lrswss/esp8266-wifi-power-meter/(threads)

Thread 1 (2021-04-17):

Code Beschreibung

Sjirka83, 2021-04-17:
Hallo Lars,

tolles Projekt, dass endlich mal die analoge Schnittstelle des Sensors nutzt und da drauf die Impulse des Stromzählers ausließt.
Mit der digitalen Ausgabe hatte ich genau die gleichen Probleme, dass der Schwellwert einfach nicht zu finden war.
Deine Lösung ist wohl der perfekte Weg, wenn man den alten Zähler gerne auslesen möchte. Super Umsetzung!!!

Da ich aber absolut neu in Sachen Arduino und der Microcontrollertechnik bin, habe ich etwas Schwierigkeiten den Code für meine Bedürfnisse anzupassen bzw. alle Abschnitte korrekt zu verstehen.

1. Ich kann den Gesamtverbrauch mit http://<ip>/setCounter?set=18231.1 nicht anpassen. Dieser schlägt immer fehl. Muss ich hier noch etwas anderes beachten?
2. Kann ich per http Befehl den Schwellwert anpassen, so dass ich diesen noch etwas "nachjustieren" kann?
3. Wie oft wird der EEPROM mit dem aktuellen Wert aktualisiert? Wenn ich das System neustarte, wird der EEPROM beschrieben, doch passiert es auch automatisch zwischendurch?!
4. Kannst du den Code auch ohne Anbindung von MQTT etc. bereitstellen? Die Ausgabe aller Werte einfach nur als JSON erweitern, so dass diese per http abgefragt werden können? Ich habe zwar die Ausgabe bereits realisiert, doch im "Code" einfach nach meinem "Wissen" hinzugefügt. Das geht bestimmt noch besser. :-)

Auch wenn das Projekt schon etwas her ist, würde ich mich sehr freuen, wenn du mir eine Rückmeldung zu den Fragen geben kannst.

Viele Grüße

lrswss, 2021-04-20:
Ich muss leider zugeben, dass ich schon eine ganze Weile eine neuere Version bei mir (als Sensor für Home Assistant) in Betrieb habe, es aber bisher irgendwie versäumt hatte, diese auch hier mal (dokumentiert) hochzuladen. :blush: Deine Anregungen ließen sich alle recht leicht umsetzen. Es ist also endlich Zeit für eine v1.2!

zu 1) Die Doku zu diesem Befehl im Code war fehlerhaft, hab's nun ins README aufgenommen.
zu 2) Ich habe einen passenden Befehl (setThreshold) implementiert (siehe README).
zu 3) Counter, CounterOffset und ImpulseThreshold werden alle 60 Min. gespeichert (früher 120 Min.).
zu 4) Ist nun beides auch möglich: ENABLE_MQTT auskommentieren bzw. /readings für den RESTful Aufruf nutzen.

Bitte testen. Über ein Feedback würde ich mich freuen...

Grüße
Lars

Sjirka83, 2021-04-20:
Hallo,

vielen vielen Dank für die ausführlichen Infos. Ich werde testen und berichten. :-)
Ich habe den Zähler jetzt ein paar Tage bereits laufen lassen. Der Zähler läuft einwandfrei und nach ein wenig justieren, wirklich sehr genau.... BIS der Durchlauferhitzer anspringt. Dann liegen 21 KW Drehstrom an und die Scheibe rennt! Leider mit den jetzigen Einstellungen zu schnell um die rote Makierung noch zu erkennen. Wenn ich den Code richtig verstehe, muss der Pegel für die Erkennung des silbernen Bereiches erst eine gewisse Zeit gehalten werden, bis der rote Bereich "neu" gezählt werden darf?!? Oder würde es schon reichen die "Debouncezeit" niedriger zu stellen. Wie könnte das denn erfolgen?!

Im ESPEASY habe ich den Sensor einmal als "Switch" konfiguriert um zu schauen, ob ich die sehr schnellen Impulse zählen könnte. So wird nur der Zustand 1 und 0 im Wechsel gezählt, was dazu führt das der Zähler sehr genau, unabhängig der Zeit für eine Runde und sehr schnell reagiert. Problem ist hier nur wieder die Einstellung des Sensors dann direkt an der Scheibe selbst. Aufgrund des Digitalen Ausgangs, kann nur der Potentiometer zur Einstellungen genommen werden, doch dieser gleicht eher dem Glaskugellesen.

Gerne würde ich an der anlogen Variante noch ein wenig "rumfeilen", da sie an sich wunderbar läuft und für alle weiteren Auswertungen sehr komfortabel ist. Würde aus deiner Erfahrung die Einstellung der Debouncetime hier noch etwas bringen um eine ganz langsam drehende Scheibe, so wie die sehr schnelle Bewegung zählen zu können?

Viele Grüße

lrswss, 2021-04-21:
So schnell dreht sich bei uns die Schreibe glücklicherweise nie. :astonished: Den Code hatte ich mal kurz mit etwa 10kW (Ofen, Toaster, Fön, Wasserkocher,...) getestet. Ich nehme mal an, deine TURNS_PER_KWH liegen auch bei 75, oder? In deinem Fall würde ich tatsächlich IMPULSE_DEBOUNCE_SEC auf 2 Sekunden reduzieren (sollte dann bei ca. 27 Umdrehungen pro Min. knapp passen) und auch die Abtastrate READINGS_INTERVAL_MS von 100 auf 50 ms anpassen. Ansonsten vllt. auch mal die Debug-Möglichkeit mit InfluxDB/Grafana ausprobieren; dann sieht's du die abgetasteten Impulse besser und kannst die Parameter entsprechend gezielter anpassen.

lrswss, 2021-05-08:
Und, hat die Anpassung von IMPULSE_DEBOUNCE_SEC bzw. READINGS_INTERVAL_MS den gewünschten Erfolg gebracht?

Closed 2021-07-24.

Thread 2 (2021-08-08):

error: call of overloaded 'abs(uint32_t)' is ambiguous

Conor-Burns, 2021-08-08:
Hi,
sehr cooles Projekt da es den Analogen output benutzt!
Leider erhalte ich beim kompilieren den Fehler im Titel für die Zeilen: 331, 793, 838 und 857

lrswss, 2021-08-09:
Da ich inzwischen (für andere Projekte) auf PlatformIO umgestiegen bin, hatte ich meine Arduino IDE schon eine Weile nicht mehr aktualisiert. Mit der 1.8.10 gibt es (noch) keine Warnungen, mit der aktuellen 1.8.15 und aktuellen ESP8266 Tools hingegen schon. Ich habe den problematisch `abs(uint32_t)` Aufruf für den Zeitstempelvergleich mit millis() nun in ein eigene Funktion verpackt.

Conor-Burns, 2021-08-09:
Ja ich benutze auch platformio für alles und hatte das importiert.

Dankeschön ich probier das nachher mal aus

Conor-Burns, 2021-08-10:
@lrswss Das funktioniert soweit doch jetzt hab ich dieses problem:
```
  431 |     snprintf(clientid, sizeof(clientid), MQTT_CLIENT_ID, random(0xffff));
      |                                          ^~~~~~~~~~~~~~
Compiling .pio/build/d1_mini/FrameworkArduino/StreamSend.cpp.o
Compiling .pio/build/d1_mini/FrameworkArduino/Tone.cpp.o
Compiling .pio/build/d1_mini/FrameworkArduino/TypeConversion.cpp.o
/home/conor/Documents/PlatformIO/Projects/210808-200442-d1_mini/src/esp8266-wifi-power-meter.ino:469:1: error: control reaches end of non-void function [-Werror=return-type]
  469 | }
      | ^
```

lrswss, 2021-08-12:
So, das Projekt lässt sich nun auch unter PlatformIO compilieren.

Conor-Burns, 2021-08-20:
mega, dankeschön!

Closed 2021-08-20.

Thread 3 (2022-07-13):

MQTT Broker connection failed

xxLexanixx, 2022-07-13:
[12:43:11]Connecting to MQTT Broker 192.168.xxx.xxx as PowerMeter_1e9cc...failed (error 5)
[12:43:12]Connecting to MQTT Broker 192.168.xxx.xxx as PowerMeter_ba257...failed (error 5)
[12:43:13]Connecting to MQTT Broker 192.168.xxx.xxx as PowerMeter_91488...failed (error 5)

lrswss, 2022-07-13:
Believe it or not, the code for an authenticated mqtt connection was simply missing. :blush: Fixed with 2.1.2.

Closed 2022-07-13.

Thread 4 (2022-07-16):

Meter number

nonick321, 2022-07-16:
Hi,

thanks for your hard work, it works like a charm :-).

I'm wondering where in the code i can change the meter-number. Here it is sth like 078893. i'd like to change it to the real meter-number from the Stromnetzbetreiber :-), especially because the number shows up in the mqtt-message.

Feature request: Mqtt Port in the GUI.

btw: You didn't change the Version number to 212 in config.h .. Don't know if that matters..

btw2: Is there a reason why WiFiUDP.h isn't in your Code? Perhaps you should mention it in your readme.

Cheers,
Alex

lrswss, 2022-07-17:
The number is derived from the MAC address of the ESP8266, but making it configurable is no big deal. Same holds true for the MQTT port.

The header file WiFiUDP.h is included in influx.h. Do you get compiler warnings/errors or why are you asking? Mentioning the old version number I guess you're using the Arduino IDE, right? I switched to VisualStudio/PlatformIO quite a while ago, so I no longer compile the code explicitly under the Arduino IDE.

nonick321, 2022-07-17:
Thank you, I found the codeparts with the MAC or systemID Call.

No, i freshly installed Visual Code and PlatformIO. I then cloned into your repository and opened the folder in Visual Code. The compiler complained about the missing WiFiUDP.h.  After adding it manually under "include", the compilation went through without errors.

sorry, i'm new to this whole stuff. This is my first project ...

Another Question: I added your Project via MQTT to iobroker. MQTT connection drops twice per minute with "connection lost: Timeout". Any idea how i can fix this? My fritzbox shows Signalstrength of -79 to -74 which is not too good, but the GUI is responsive

lrswss, 2022-07-17:
Just uploaded v2.1.3 with options in web ui to configure the MQTT port and power meter id. Please check if it's working as expected.

Sorry, I cannot reproduce your error due to missing header WiFiUDP.h. I cleaned up my project in VS and download/compiled all libraries from scratch: no warnings or errors message from the compiler.

I'm using HA and never experienced any connection timeout warnings. Low signal strength is probably not the cause. But I think the warnings are no matter of concern. Looking at the source code of the PubSubClient library I found MQTT_KEEPALIVE and MQTT_SOCKET_TIMEOUT to be set to 15 seconds by default. Timeout and keep alive could be increased with setSocketTimeout() and setKeepAlice() in mqtt.cpp which might fix iobroker's complains. You could try to set the publish interval to 30 or even 15 secs and check if you still get connect lost warnings.

nonick321, 2022-07-18:
Thank you so much. I changed the timeout and keepalive to 40 seconds and the publish intervall to 30s. The connection is now stable and no more warnings in iobrokers log.

All your other changes (Meter Name, Port) work great. Thanks for this!

Closed 2022-07-18.

Thread 7 (2022-10-16):

Revolutions not counted when using > 500 Watts

jellekaufmann, 2022-10-16:
Hi Lars,

I finally managed to get the power meter working correctly!

The final issue I ran into was revolutions not being counted when using a high amount of electricity.

Because calibration was working fine I figured the problem had to be in the rising edge detection.

Commenting out the two lines on row 105-106 of src/ferraris.cpp and using a 15ms sample rate fixed my problem.

I guess this is caused by my very fast spinning meter.

```
// try to find a rising edge in previous analog readings
static bool findRisingEdge() {
    uint16_t i, belowThresholdTrigger;
    uint8_t s = 1;
    uint16_t belowTh = 0;
    uint16_t aboveTh = 0;

    // reading interval min. 50ms
    //if (50 / settings.readingsIntervalMs > 1)
    //    s = 50 / settings.readingsIntervalMs;

    // min. number of pulses below threshold required to detect a rising edge
    belowThresholdTrigger = (settings.pulseDebounceMs / 2) / settings.readingsIntervalMs;

    i = ferraris.index > 0 ? ferraris.index : ferraris.size - 1;
```

I don't know how (or if) you want to resolve this issue, maybe a button on the advanced settings panel? Or turning off the minimum interval of 50ms when a fast spinning meter is configured?

Just let me know and I'll try to come up with a pull request.

Jelle

Closed 2022-11-13.

Thread 8 (2022-10-31):

Publish totalConsumption and runtime?

steakneedy, 2022-10-31:
Hi there,

first of all thanks for the great work!

Would it be possible to also publish the total consumption via MQTT or am missing something?
I can get the data by HTTP Request, but it would be great to also have this data directly available as an entity in Home Assistant.

Thanks

lrswss, 2022-11-01:
All 4 entities displayed in the web ui are published via MQTT along with RSSI and version number. Could you please check the messages published to your broker with MQTT Explorer oder mosquitto_sub on the topic you configured under "settings". Are you using the Arduino IDE or PlatformIO to compile the software? ArduinoJson Version? Operating system?

lrswss, 2022-11-01:
Could you please check the topic HA discovery topic homeassistant/sensor/wifipowermeter-74DAE9 with MQTT Explorer. You should see 5 entities: pulse_count, total_consumption, current_power, signal_strength and runtime. It might help to remove the power meter's entry from HA's devices page and delete the above mentioned topic. Then restart the power meter to retrigger HA MQTT discovery.

lrswss, 2022-11-02:
IDE? Operating system? ArduinoJSON version? Did you remove the topic homeassistant/sensor/wifipowermeter-74DAE9?

lrswss, 2022-11-02:
Just a wild guess: try to increase the size of StaticJsonDocument in mqtt.c (line 30) from 512 to 640.

lrswss, 2022-11-03:
I have no idea why this topic doesn't show up in your setup. Never had this problem. Could you please post the output from the PlatformIO console, when you compile the software. Everything from "PLATFORM:" up to and including the "Dependency Graph".

I'm on vacation right now, so I can't do any further testing with my wifi power meter. I will get back to you at the beginning of next week.

xammmue, 2022-11-04:
Hello,
installed the meter yesterday and switched on home assistant discovery this morning.
I do as well only get 4 entities inside home assistant, total consumption is missing here too.
Those are the entities I do have:
```
homeassistant/sensor/wifipowermeter-7A0979/pulse_count
homeassistant/sensor/wifipowermeter-7A0979/current_power
homeassistant/sensor/wifipowermeter-7A0979/signal_strength
homeassistant/sensor/wifipowermeter-7A0979/runtime
```

Using firmware 223.
I compiled the firmware using Win10 and VSCode as well. I will later also check on the ArduinoJSON version.

The jsonData published to the other mqtt topic which is not used for home assistant looks just fine:
`{"counter":907,"consumption":85492.88,"power":1495,"runtime":"0d0h10m","rssi":-44,"version":223}`

lrswss, 2022-11-04:
I just checked my MQTT broker at home: the home assistant discovery message for "total_consumption" has 405 Bytes and should fit into the allocated char buffer and StaticJsonDocument according to the ArduinoJson Assistant. I'm using VS Code with PlatformIO on MacOS and discovery is working as expected. I'm pretty sure it's all about buffer allocation an different platforms: please try to increase StaticJsonDocument  in mqtt.c (line 30) from 512 to 640 and buf (line 32) from 448 to 512.

xammmue, 2022-11-04:
Just rebuilt the firmware with the changes mentioned, but the behavior did not change. I did have to set up all the settings again as they somehow got lost. Even had to set up wifi which worked just out of the box after flashing the firmware via USB yesterday (probably because of the firmware installed previously).

I also looked up my ArduinoJson version now, which is 6.19.4. So same as steakneedy.

The other discovery messages have lengths of 338 to 404 bytes. I don't see why the total power one should be a huge difference here...

Is there a way to upload the config without having to set all the settings again? That would be great for testing purposes

lrswss, 2022-11-04:
Does either of you have TLS enabled?

lrswss, 2022-11-04:
> Is there a way to upload the config without having to set all the settings again? That would be great for testing purposes

Please use `config.h` for individual sensor presets.

xammmue, 2022-11-04:
> Does either of you have TLS enabled?

I don't

lrswss, 2022-11-06:
Increasing MQTT buffer size in mqtt.c at line 179 from 480 to 512 bytes seems to fix the problem. Can you confirm?

xammmue, 2022-11-06:
I am pretty sure I tried that out 2 days ago and uploaded the new firmware via OTA onto my D1 mini, but it still did not send the message, double checked that with mqtt explorer.

Manually building and sending the message to the topic works, and the value also did get updated for a day, but that only worked until a restart of home assistant I believe

lrswss, 2022-11-06:
It's definitely a MQTT buffer size issue. Actually it has to be increased to at least 672 bytes. Buffer size for the serialized JSON has to be set to 592 bytes and the StaticJsonDocument to 640 bytes accordingly. I'll release a new version with adjusted buffer sizes in `mqtt.c` shortly after few more tests.

Output of new function `publishJSON()` in `mqtt.c` which now explicitly checks for JSON overflow after serialization and the MQTT publish return value using a MQTT buffer of 672 bytes in `mqttInit()`:
```
Sending home asssistant MQTT auto-discovery message...
MQTT homeassistant/sensor/wifipowermeter-123456/pulse_count/config (341 bytes)
MQTT homeassistant/sensor/wifipowermeter-123456/total_consumption/config (424 bytes) <- OK
MQTT homeassistant/sensor/wifipowermeter-123456/current_power/config (406 bytes)
MQTT homeassistant/sensor/wifipowermeter-123456/signal_strength/config (352 bytes)
MQTT homeassistant/sensor/wifipowermeter-123456/runtime/config (340 bytes)
```

Same with current and way too small MQTT buffer size (480 bytes):
```
Sending home asssistant MQTT auto-discovery message...
MQTT homeassistant/sensor/wifipowermeter-123456/pulse_count/config (341 bytes)
MQTT homeassistant/sensor/wifipowermeter-123456/total_consumption/config failed! <- ERROR, not published
MQTT homeassistant/sensor/wifipowermeter-123456/current_power/config (406 bytes)
MQTT homeassistant/sensor/wifipowermeter-123456/signal_strength/config (352 bytes)
MQTT homeassistant/sensor/wifipowermeter-123456/runtime/config (340 bytes)
```

Closed 2022-11-13.

Thread 9 (2022-12-18):

Possible enhancement - power saving?

ac1176, 2022-12-18:
Hi Lars,

Thanks for the effort you've gone to with this little project. I stumbled across it a few weeks ago while I was researching the possibility of reading my old spinning disc energy meters at my house and logging my energy usage. I was pleasantly surprised when your code just worked straight away without any further intervention on my part. A lot of the other projects for reading electromechanical meters I'd seen thus far seemed to require a significant amount of fine-tuning and careful planning in order for the meter to read correctly, and yours is the first one which worked first time around, which I'm really grateful for!

I was wondering if you were considering adding any form of power saving features to the ESP8266 codebase? I realise that the ESP8266 doesn't have a great deal of flexibility in terms of allowing A/D reads while in sleep, and that the very nature of the meter reads means that the CPU cannot be allowed to sleep in between pulses. But perhaps there could be an option to disable the Wifi for a period, continue to detect/count pulses in that period (with timestamps) and then enable Wifi long enough to transmit a burst of logged data for that period to MQTT? Maybe the web interface could have a selectable 'power saving' option which allows the user to specify a period of 'Wifi disabled' in minutes/hours?

My initial test setup for trying out your project was powered by a single 18650 cell, which initially worked great but didn't last overnight. My hope was that I could use a small solar cell to keep the battery topped up during the day and rely on the battery at night, or when daytime solar levels are low.

Thanks again for your work on this project!

lrswss, 2023-01-15:
I have done some tests lately. When Wifi is off, the ESP8266 power consumption drops from 78mA to about 24mA. Reducing the CPU speed from 160MHz to 80MHz helps to get close to 19mA. This is more or less consistent with what I have read in various articles on the internet. But I guess that's still quite a lot to run the Wifi power meter on a (single) 18650 cell. Using a 3000mAh cell would probably provide enough power for about 5-6 days. The only way to noticeably reduce power consumption (< 1 mA) is to use deep sleep mode, which is surely not practical for this application.

What do you think, are 19mA worth the effort to introduce a (simple) "power save mode"? Switching on Wifi, publishing data und turning off Wifi takes barely one second. Of course, the latter would also make the web interface inaccessible, since the ESP8266 only wakes up to transmit the data via MQTT. However, the power save mode could be turned off with a MQTT command topic.

To keep things simple I'd rather not implement a data backlog with timestamps...

ac1176, 2023-01-15:
> What do you think, are 19mA worth the effort to introduce a (simple) "power save mode"? Switching on Wifi, publishing data und turning off Wifi takes barely one second. Of course, the latter would also make the web interface inaccessible, since the ESP8266 only wakes up to transmit the data via MQTT.

Your test results for power consumption with and without WiFi align with what I've seen as well. A saving of three-quarters may be attractive for users who may want to use battery power.

> However, the power save mode could be turned off with a MQTT command topic.

Another possibility is that the power saving mode could be disabled using a GPIO pin. The user could install a jumper on the ESP board, or use an external switch or relay any time they want to have the WiFi activated on demand. That would allow the web interface to remain open if the user wants to log in to view metering data or make setting changes.

> To keep things simple I'd rather not implement a data backlog with timestamps...

Understood. I can see that is probably more work than it's worth in this scenario.

Having said all that, unfortunately my electricity provider has since advised me that my Ferraris meters are soon to be replaced with new smart meters which only provide pulsing LED outputs. I'm happy to do some testing for you if you feel modifying the code is something you'd like to pursue, but I fear opportunities for me to do so will soon dry up.

lrswss, 2023-02-25:
Added a power saving mode with the most recent release. The consumption of the Wifi Power Meter was reduced from 95mA to about 35mA (20mA ESP8266, 15mA TCRT5000). I had to take a few turns to deal with the unexpected change in ADC readings if ESP8266's WiFi is switched off. I'd be happy if you could give it a try.

Closed 2023-03-19.

Thread 12 (2023-03-04):

No ‚settings‘ in German UI

jeGit, 2023-03-04:
If you switch to German UI as mentioned in the description there is no ‘Settings’ Page loading after you click on the button.

lrswss, 2023-03-07:
I tried to reproduce this error by flashing a new Wemos D1 mini, but the web UI works as expected, both in English and German. Do you see any errors on the serial console? Could you please uncomment DEBUG_HEAP in utils.h, recompile and post the serial output while trying to open the settings page.

jeGit, 2023-03-08:
OK, It seems that the missing 'Settings' in German was a mistake as with a new flash it is there:
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

The UI flashing seems to go away once I went to the Settings menu, confirmed that 'MQTT' is disabled, saved and back to the main menu.
Only then the message (as in the video) 'Failed to publish to MQTT' disappears and with it the flash (constant reload of the page?) disappeared.
So maybe my sequence of working with it was a little bit off the usual path.
Thx for your quick replies.

lrswss, 2023-03-08:
Did you install version 2.4.1? The flashing error message was actually caused by a missing check if MQTT is enabled/disabled in the main loop.

jeGit, 2023-03-10:
Yes, updated now. All working as expected. Thanks.

Closed 2023-03-08.

Thread 13 (2023-03-04):

Main page starts flashing

jeGit, 2023-03-04:
Main page starts flashing and displays MQTT error.
MQTT is not activated in Settings.
https://user-images.githubusercontent.com/23298068/222931889-25db709a-7dc5-4b8b-80d1-924101a82247.MOV

lrswss, 2023-03-06:
To help you, I need a few more details about your setup: 1) First time installation or update (previous version)? 2) Browser used? 3) Compiled/Flashed with Arduino IDE (Version?) oder PlattformIO? Current settings as JSON?

I just did a fresh install with 2.4.0 on a new Wemos D1 recently (using PlatformIO) and did not run into problems like #12 or #13.

jeGit, 2023-03-07:
Thanks for your reply.
1. First time install
2. FF and Chrome on Mac and Edge on Windows
3. PlatformIO
No changes on the project files.
Please explain 'current settings as JSON'

Closed 2023-03-07.

Thread 14 (2023-03-13):

MQTT Data not send

alkaraschu, 2023-03-13:
Hey Lars, great job and a very useful project. Thank you for your great idea! Initially all worked fine. The manual for installation is perfectly written. Now it happens, after restarts, that I do have a Wifi-connection (-65 dbm) but either the IR-sensor is not counting, data are not published over MQTT or both. The green lights of the module are working ( one permanently and one is flashing when the red mark is passing). Any Tips from your side?

lrswss, 2023-03-13:
First time install or did you recently upgrade to the current version (2.4.1)? Do you see anything useful on the serial output of the Wemos D1 mini? Please post an excerpt from the serial output (including a system reset) here. Have you tried to set/calibrate a new threshold value for the red marker? Your MQTT settings: Auth on/off, TLS on/off?

alkaraschu, 2023-03-13:
I did an upgrade to 2.4.1. MQTT publishing is running stabil now. Calibrating the threshold value for the red marker under high load is ending up with "Not enough measurements". Setting it to 75 or 50 doesn't bring the IR sensor to count the rounds even the one green light on the IR is flashing when the red marker is passing. I do not want to bother you. Thanks for help

lrswss, 2023-03-19:
Did you eventually get it to work?

Closed 2023-03-18.

Thread 15 (2023-12-28):

Settings bleiben leer

yasars, 2023-12-28:
Hi habe gerade ein update gemacht und ich weiss jetzt icht ob es vorher auch schon so war... aber sobald alles eingestelltist kann man auf die settings seite nicht zugreifen ...
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

yasars, 2023-12-28:
solltest du trotzdem mal im auge behalten ... nach 2-3 reboots habe ich wieder zugriff drauf...

Closed 2023-12-28.
