lrswss/esp8266-wifi-power-meter/include/config.h

/***************************************************************************
  Copyright (c) 2019-2023 Lars Wessels

  This file a part of the "ESP8266 Wifi Power Meter" source code.
  https://github.com/lrswss/esp8266-wifi-power-meter

  Licensed under the MIT License. You may not use this file except in
  compliance with the License. You may obtain a copy of the License at

  https://opensource.org/licenses/MIT

***************************************************************************/

#ifndef _CONFIG_H
#define _CONFIG_H

// uncomment for german ui, defaults to english
#define LANGUAGE_EN

//
// the following options can also be set in web ui
//

// this value has to be set according
// to the specs of your ferraris meter
#define TURNS_PER_KWH 75

// calculate current power consumption (watts) from previous marker interval;
// when the ferraris disk rotates rather slowly on low power consumption
// this value can only be updated about once every 1-2 minutes
#define CALCULATE_CURRENT_POWER

// optionally apply a moving average to power consumption calculations
// interval used for average calculation, set to 0 to disable
#define POWER_AVG_SECS 120

// publish power meter readings via MQTT (optional)
//#define MQTT_ENABLE
#define MQTT_PUBLISH_JSON
#define MQTT_BROKER_HOSTNAME "__mqtt_broker__"
#define MQTT_BROKER_PORT 1883
#define MQTT_BASE_TOPIC "__mqtt_topic__"
#define MQTT_PUBLISH_INTERVAL_SEC 60

// uncomment to enable MQTT authentication
//#define MQTT_USERNAME "admin"
//#define MQTT_PASSWORD "secret"

// uncomment to enable encrypted MQTT connection
// MQTT must have TLS enabled on port 8883
//#define MQTT_USE_TLS

// uncomment to enable Home Assistant MQTT auto discovery
//#define MQTT_HA_AUTO_DISCOVERY

// switch off Wifi inbetween MQTT messages (95mA -> 35mA)
// If enabled, you cannot set the MQTT publish interval below
// MQTT_INTERVAL_MIN_POWERSAVING_SECS (see mqtt.h).
// Since Wifi is switched on only for 2 seconds to publish meter
// readings the web ui will be inaccessible. To regain access to
// the web ui you need to power down the Wifi power meter or publish
// a MQTT message to (cmd/powersave 0) to disable power saving mode
// internal web server will run for 5 min. before switching back
// to power saving mode unless you disable the option under settings
//#define POWER_SAVING_MODE

// optional preset power meter's id (e.g. number of ferraris meter)
// defaults to last 3 octets of ESP8266's MAC address
// (string with max. 16 characters)
//#define SYSTEM_ID "12345678"

// the following settings should be changed with care
// better use web ui (expert settings) for fine-tuning 
#define READINGS_BUFFER_SEC 90
#define READINGS_INTERVAL_MS 25
#define READINGS_SPREAD_MIN 3
#define ABOVE_THRESHOLD_TRIGGER 3
#define PULSE_DEBOUNCE_MS 2000
#define BACKUP_CYCLE_MIN 60

// For debugging purposes only
// Raw analog readings (READINGS_INTERVAL_MS) from the IR sensor are 
// send to an InfluxDB which has to configured to accept data on a 
// dedicated UDP port. Can also be enabled/disabled in web ui but HOST, 
// PORT, TAG need to preset here. Use this if threshold auto-detection
// fails or you want to fine-tune it
//#define INFLUXDB_ENABLE
#define INFLUXDB_HOST "__influxdb_server__"
#define INFLUXDB_UDP_PORT 8089
#define INFLUXDB_DEVICE_TAG "__wifipowermeter__"

// to make Arduino IDE happy
// version number is set in platformio.ini
#ifndef FIRMWARE_VERSION
#define FIRMWARE_VERSION 242
#endif

// set default port for MQTT over TLS
#ifdef MQTT_USE_TLS
#undef MQTT_BROKER_PORT
#define MQTT_BROKER_PORT 8883
#endif

// enable MQTT and JSON if HA discovery is set
#ifdef MQTT_HA_AUTO_DISCOVERY
 #ifndef MQTT_ENABLE
 #define MQTT_ENABLE
 #endif
 #ifndef MQTT_PUBLISH_JSON
 #define MQTT_PUBLISH_JSON
 #endif
#endif

#ifndef MQTT_ENABLE
 #undef POWER_SAVING_MODE
#endif

#endif
