lrswss/esp8266-wifi-power-meter/(commit log)

2021-04-20 runtime counter fix, use json for ui update
    - fixed total runtime counter overflow in getRuntime()
    - use a RESTful/JSON api to update web ui instead of simple csv
    - added sendCORS() and setCrossOrigin() for remote RESTful requests
    - simplified EEPROM code using EEPROM_Rotate's native get() and put()
    - web ui message passing is now part of handleGetReadings()
    - added HTTP command 'setThreshold' to tune value for impulse threshold
    - power meter readings are now published as a JSON on MQTT_BASE_TOPIC by
    default; uncomment MQTT_PUBLISH_JSON to reactivate multi-topic setup
    - MQTT support can be disabled by uncommenting MQTT_ENABLE
    - use INFLUX_ENABLE to activate InfluxDB support instead of INFL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
    [index_de.h, index_en.h]
2021-08-09 fix abs() compiler error, added system id to topic
    - fix 'call of overloaded abs(uint32_t) is ambiguous' error
    (issue #2) by introducing new function tsDiff() which returns
    the rollover safe difference to current millis() in ms
    - a system id (last 3 bytes of MAC) is now part of MQTT topic
    - decrease IMPULSE_DEBOUNCE_SEC from 5 to 3 secs (might fix issue #1)
    - changed getRuntime() to return string with runtime info with or
    without spaces making removeBlanks() superfluous
    - fixed few typos and indents
    - version 1.2.1
2022-06-10 v2.0, platformIO
    - moved development from Arduino IDE to PlatformIO
    - split original code from single *.ino file across several source and header files
    - all system settings can now be changed in two new setting tabs in web ui
    - use WiFiManager to initially configure WiFi and credentials
    - more or less rewrote the code for embedded web server
    - settings are also stored in (pseudo) EEPROM, config.h is only used for presets
    - use averaged A/D readings from IR sensor
    - added new template for OTA firmware update
    - updated README
    - new major version 2.0
2022-06-12 v2.1, added current consumption
    - added current consumption calculated from recent pulse interval
    - optional moving average for current consumption reading
    - added total meter reading and current consumption to struct ferraris_t, both
    are now calculated only in readFerraris() and initially in initFerraris()
    - IR sensor reading interval reduced to 25ms (was 50ms)
    - updated limits for expert settings to theoretically fit higher ferraris speeds
    - fixed topic string for RSSI in publishDataSingle()
    - added missing option for 'publish as JSON' to main settings
    - now also publishing firmware version
    - check if firmware file was selected on embedded OTA page
    - update README, screenshots and restfu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
    [config.h, ferraris.cpp, ferraris.h, index_de.h, index_en.h, main.cpp, mqtt.cpp, mqtt.h]
2022-06-16 v2.1.1, set total consumption fixed
    - immediate update of total consumption under settings
    - added progress bar to firmware upload form
    - version 2.1.1
    [config.h, index_de.h, index_en.h, web.cpp]
2022-07-13 v2.1.2, fixed mqtt authentication
    - code for authenticated mqtt connection was missing :-O
    - reduced delay between mqtt connection attempts
    - few minor changes to messages in web ui
    - instantiate WifiManager in wlan.cpp
    - version 2.1.2
    [index_de.h, index_en.h, mqtt.cpp, utils.cpp, wlan.cpp]
2022-07-17 v2.1.3, mqtt port and meter id configurable
    - make MQTT port and power meter id configurable in web ui
    - fixed non-functional js input validation on settings page
    - rewrote send2influx_udp() removing most String() calls
    - small changes to error messages on settings pages
    - added F() macro to some more println() calls
    - version 2.1.3
    [config.h, index_de.h, index_en.h, influx.cpp, influx.h, mqtt.cpp, nvs.cpp, nvs.h]
2022-07-23 v2.2.0, TLS support, home assistant discovery
    - added TLS to encrypt MQTT connection (without server fingerprinting)
    - increased CPU speed from 80 to 160 MHz for TLS
    - added option for Home Assistant MQTT sensor auto-discovery
    - set MQTT keep-alive timeout to match publish interval
    - version 2.2.0
2022-09-07 Fix typo in include
    [influx.h]
2022-09-19 v2.2.2, tweaked HA mqtt auto discovery
    - include device name and user configurable system id in HA's entity names
    - added state_class attribute to entity total consumption (total_increasing)
    and current power (measurement) to make wifi power meter show up in HA's
    energy tab
    - tweaked memory allocation in publishHADiscoveryMessage and publishDataJSON
    - version 222
2022-09-19 v2.2.3, more HA auto discovery tweaks/fixes
    - fixed (too) low memory allocation for JSON used by auto discovery in HA
    bug was introduced in v222 tweaking StaticJsonDocument a little too much
    - changed/added icons for published entities; fixed typo in WiFi
    - v223
    [config.h, mqtt.cpp]
2022-10-17 v2.2.4, fix influxdb debugging
    - fixed a typo introduced in v2.1.3 that broke sending raw A/D sensor data to InfluxDB
    - updated inline comments on InfluxDB's line protocol from v1.7 to more recent v2.4
    - added a screenshot with A/D readings from InfluxDB’s Data Explorer to README
    - v224
    [config.h, influx.cpp]
2022-11-13 v2.3.0, fixed issue #7 and #8
    - issue #7: removed old code fragment limiting reading interval from findRisingEdge()
    - issue #8: increased size for JSON docs and MQTT connection buffers in mqtt.c
    - added publishJSON() which carefully checks JSON serialization and MQTT return codes
    - use addDeviceDescription() to add device info to HA discovery topics
    - if HA discovery is disabled also delete corresponding configuration topic for HA
    - always disconnect from MQTT server when saving main settings
    - hide field in web ui to specify time for moving average if set to 0 in config.h
    - reconnect to WiFi every 30 secs. and blink LED if WiFi offline and publish additional
    topic with WiFi reconnect coun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
    [config.h, ferraris.cpp, index_de.h, index_en.h, main.cpp, mqtt.cpp, mqtt.h, nvs.cpp]
2023-01-31 v2.3.1, fixed units for HA (PR #10)
    - fixed unit of measurement on mqtt values for home assistant
    - fixed another typo in mqtt.cpp
    - bumped to version 2.3.1
    [config.h, mqtt.cpp]
2023-02-25 backup/restore config, power saving mode (#9)
    - added new option to backup/restore system configuration as JSON file
    - introduced (experimental) power saving mode (see issue #9) switching off
    WiFi between MQTT messages (reducing power consumption from 95mA to 35mA)
    - lowered CPU speed from 160 to 80Mhz
    - breaking change: MQTT messages are now published unter subtopic 'state'
    if you're using HA discovery, changes will take effect automatically
    - added stopWifi() and restartWifi() to toggle Wifi for power saving mode
    - moved Wifi auto reconnect function from main.cpp to reconnectWifi()
    - new MQTT topic 'wifisecs' accumulates seconds if Wifi is switched on/off
    - since ADC readings seem to c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
    [config.h, ferraris.cpp, ferraris.h, index_de.h, index_en.h, main.cpp, mqtt.cpp, mqtt.h]
2023-03-07 fix issue #13
    - added missing check if MQTT is enabled in main() fixing issue #13
    - issue warning about failed MQTT connection
    - explicitly check whether MQTT publishing failed or succeeded and
    issue a corresponding warning or confirmation in web interface
    - version 2.4.1
    [config.h, index_de.h, index_en.h, main.cpp, mqtt.cpp, mqtt.h]
2023-12-28 Fixes for HA MQTT auto discovery
    - HA: removed name of device from entity names to fix HA's warning
    message 'MQTT entity name starts with device name' (since 2023.8)
    - HA: corrected unit of measurement for uptime minutes ('min' not 'm')
    - HA: value for 'identifiers' in device description must be an array
    - HA: removed MQTT topic for WiFi reconnect counter if device is in
    power saving saving mode (than replaced by WiFi connect timer) and
    vice versa in continuous WiFi connection mode
    - don't increment 'wifiReconnectCounter' in power saving mode
    - fixed HTML REST demo template to display runtime in minutes
    - NOTE: this is probably the last release since our ferraris meter
    will finally b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
    [config.h, mqtt.cpp, wlan.cpp]
